Tomiinek/Star_Tracker/Star_Tracker.ino

#include "src/config.h"
#include "src/control/control.h"

#include "src/core/motor_controller.h"

#include "src/core/camera_controller.h"
#include "src/core/canon_eos1000d.h"

#include "src/core/clock.h"
#include "src/core/rtc_ds3231.h"

RtcDS3231 ds3231;
Clock& persistent_clock = ds3231;

CanonEOS1000D eos;
CameraController& camera = eos; 

MountController mount(MotorController::instance());

Control control(mount, camera, persistent_clock);

void setup() {

  Serial.begin(SERIAL_BAUD_RATE);
  delay(10);
  control.initialize();
  delay(100);

}

void loop() {

  control.update();
  delay(10);

}
