Tomiinek/Star_Tracker/(commit log)

2019-06-16 Initial stepper motors controller.
2019-06-30 Initial camera controller
2019-06-30 Mount controller without calibration
2019-06-30 Queue for stacking motor movements
2019-08-04 First working version
    [catalog.csv]
2019-08-07 Wiring diagram
2019-08-29 Canon EOS trigger bugfix.
    [canon_eos1000d.h]
2020-04-06 Fix division by 0
    [motor_controller.cpp]
2021-01-21 Renamed clock to avoid conflicts with libraries.
    [Star_Tracker.ino]
